hhintoglu/FMCW_Based_Distance_Measuring_System/README.md

# FMCW_Based_Distance_Measuring_System
Repo for Frequency Modulated Continuous Wave Based Distance Measuring System ( A Radar Project)
