hhintoglu/FMCW_Based_Distance_Measuring_System/Simulations/Active_Low_Pass.asc

C1: cap
R1: res
R2: res
R3: res
U1: UniversalOpamp2
V1: voltage; -12V
V2: voltage; 12V
Named nets: Vcc, Vee, 0
