hhintoglu/FMCW_Based_Distance_Measuring_System/Simulations/Microphone_Driver.asc

C1: cap; 1µF
C2: cap; 1µF
Microphone: signal; ""
Q1: npn
R1: res; 10k
R2: res; 100k
R3: res; 10k
R4: res; 100
Named nets: 0, 12V
