hhintoglu/FMCW_Based_Distance_Measuring_System/Simulations/Microphone_Driver_Real.asc

C1: cap; 1µF
C2: cap; 100nF
Q1: npn
R1: res; 10k
R2: res; 100k
R3: res; 10k
R4: res
V1: voltage; 12v
V2: voltage; PULSE(-20mV 20mV 0 1n 1n 125u 250u)
Named nets: 0
.tran 0 1.01 1
