hhintoglu/FMCW_Based_Distance_Measuring_System/Simulations/Mixer.asc

D1: diode; 1N914
D2: diode; 1N914
D3: diode; 1N914
R1: res; 1k
R2: res; 1k
R3: res; 1k
R4: res; 1k
R5: res; 1k
R6: res; 1k
R7: res; 1k
R8: res; 1k
R9: res; 1k
R10: res; 1k
U1: UniversalOpamp2
U2: UniversalOpamp2
U3: UniversalOpamp2
U4: UniversalOpamp2
U5: UniversalOpamp2
V1: voltage; -12V
V2: voltage; 12V
V3: voltage; PULSE(-12 12 0 1n 1n 125u 250u)
V4: voltage; PULSE(-12 12 0 1n 1n 119u 238u)
V5: voltage; PULSE(-12 12 0 1n 1n 125u 250u)
V6: voltage; PULSE(-12 12 0 1n 1n 119u 238u)
Named nets: 0, Vcc, Vee
.tran 0 1.01 1
