hhintoglu/FMCW_Based_Distance_Measuring_System/Simulations/Mixer_Circuit.asc

C1: cap; 0.1µF
C2: cap; 0.1µF
C3: cap; 0.1µF
M1: nmos
R1: res; 100k
R2: res; 100k
R3: res; 8.2k
Named nets: -12V, 12V, Input1, Input2
