hhintoglu/FMCW_Based_Distance_Measuring_System/Simulations/Mixer_Circuit_Real.asc

C1: cap; 0.1µF
C2: cap; 0.1µF
C3: cap; 10nF
M1: nmos
R1: res; 100k
R2: res; 100k
R3: res; 8.2k
V1: voltage; SINE(0 10 1k)
V2: voltage; SINE(0 10 10k)
V3: voltage; 12V
V4: voltage; -12V
Named nets: 0
.tran 0 1.05 1
