hhintoglu/FMCW_Based_Distance_Measuring_System/Simulations/Square_VCO.asc

C2: cap; 1n
M1: nmos
R1: res; 47k
R2: res; 22k
R3: res; 47k
R4: res; 4.7k
R5: res; 22k
R6: res; 22k
R7: res; 22k
U1: UniversalOpamp2
U2: UniversalOpamp2
V1: voltage; -12
V2: voltage; -12
V3: voltage; -12
V4: voltage; -12
V5: voltage; PULSE(1.7 8.7 0 50m 50m 1n 100m)
Named nets: 0
.tran 0 1.05 1 uic
